nh-github/nav_lights/firmware/README.md

This directory contains firmware for the navigation lights
