nh-github/nav_lights/cad/cad_files/partlist.ods

parts | $/ea | footprint | digikey | mfr # | dscr | alt | note
Rc101 | 0.1 | R4-LARGE_PADS | JW50ZT0R00CT-ND | JW50ZT0R00 | RES 0.0 OHM 3A JUMP AXIAL | (SM/TH) 0 ohm resistor | Jumper for battery power
Rc102 | 0.1 | SM1206 | 1276-5742-1-ND | RC3216F103CS | RES SMD 10K OHM 1% 1/4W 1206 |  | LED temp sense, same as Rp107..
Rc103 | 0.67 | R4-LARGE_PADS | A105970CT-ND | 1622796-6 | RES 10.0K OHM 1/4W 0.1% AXIAL |  | LED temp sense
THc101 | 1.08 | SM1206 | 541-1150-1-ND | NTHS1206N02N1002JE | THERMISTOR NTC 10K OHM 5% 1206 | BC2558CT-ND (0805, 10k, 1%, B3570K) | LED temp, b=3500K
THc102 | 1.12 | R4-LARGE_PADS | 615-1054-ND | DC103G9G | THERMISTOR NTC 10K OHM 2% |  | LED temp, b=3575K
Uc101 | 0.26 | DIP-24__600_ELL | ED3051-5-ND | ED24DT | CONN IC SOCKET VERT 24POS TIN |  | use socket for arduino pro mini 3.3V 8MHz
BTp101, BTp102 | 1.36 |  | 2460K-ND | 2460 | HOLDER BATTERY 1CELL AA PC MNT |  | AA holder, Keystone Electronics
Cp101 | 0.28 | SM1206 | 445-14795-1-ND | C3216X7R1C475K085AB | CAP CER 4.7UF 16V 10% X7R 1206 | 445-1421-1-ND (0805, 4.7uF, 6.3V) | same as Cp201
Cp102 | 0.1 | SM1206 | 1276-1017-1-ND | CL31B104KBCNNNC | CAP CER 0.1UF 50V 10% X7R 1206 |  | CHECK
Cp103 | 0.16 | SM1206 | 1276-1783-1-ND | CL31B105KOFNNNE | CAP CER 1UF 16V 10% X7R 1206 |  | CHECK
Dp101 | 0.44 | DO-214AA | B340LB-FDICT-ND | B340LB-13-F | DIODE SCHOTTKY 40V 3A SMB
Dp102 | 0.44 | DO-214AA | B340LB-FDICT-ND | B340LB-13-F | DIODE SCHOTTKY 40V 3A SMB
Dp103 | 0.34 | SM1206 | 732-4994-1-ND | 150120YS75000 | WL-SMCW SMD CHIP LED WATERCLEAR |  | Yellow 1206 LED, 20mA
Lp101 | 1.88 |  | 445-10541-1-ND | SLF12565T-470M2R4-PF | FIXED IND 47UH 2.4A 57.8 MOHM
Pp101 |  | PIN_ARRAY_2X1 |  |  |  |  | CHECK
Qp101 | 0.78 | SOT23_6 | ZXM62P02E6CT-ND | ZXM62P02E6TA | MOSFET P-CH 20V 2.3A SOT23-6
Qp102 | 0.71 | SOT89 | FCX718CT-ND | FCX718TA | TRANS PNP 20V 2.5A SOT89
Rp101 | 0.1 | SM1206 | 1276-5690-1-ND | RC3216F331CS | RES SMD 330 OHM 1% 1/4W 1206
Rp102 | 0.1 | SM1206 | 1276-3514-1-ND | RC3216J000CS | RES SMD 0.0 OHM JUMPER 1/4W 1206
Rp103 | 0.1 | SM1206 | 1276-5685-1-ND | RC3216F271CS | RES SMD 270 OHM 1% 1/4W 1206
Rp104 | 0.1 | SM1206 | 1276-5675-1-ND | RC3216F151CS | RES SMD 150 OHM 1% 1/4W 1206
Rp105 | 0.1 | SM1206 | 1276-5742-1-ND | RC3216F103CS | RES SMD 10K OHM 1% 1/4W 1206
Rp106 | 0.1 | SM1206 | 1276-5671-1-ND | RC3216F101CS | RES SMD 100 OHM 1% 1/4W 1206
Rp107 | 0.1 | SM1206 | 1276-5742-1-ND | RC3216F103CS | RES SMD 10K OHM 1% 1/4W 1206 |  | same as Rp105
Rp108 | 0.1 | SM1206 | 1276-5742-1-ND | RC3216F103CS | RES SMD 10K OHM 1% 1/4W 1206 |  | same as Rp105
Rp109 | 0.1 | SM1206 | P10.0FCT-ND | ERJ-8ENF10R0V | RES SMD 10 OHM 1% 1/4W 1206
Rp110 | 0.1 | SM1206 | 1276-5762-1-ND | RC3216F333CS | RES SMD 33K OHM 1% 1/4W 1206
Rp111 | 0.1 | SM1206 | 1276-5784-1-ND | RC3216F124CS | RES SMD 120K OHM 1% 1/4W 1206
Rp112 | 0.21 | SM1206 | 1276-6178-1-ND | RUT3216FR300CS | RES SMD 0.3 OHM 1% 1/3W 1206
THp101, THp102 | 1.08 | SM1206 | 541-1150-1-ND | NTHS1206N02N1002JE | THERMISTOR NTC 10K OHM 5% 1206 | BC2558CT-ND (0805, 10k, 1%, B3570K) | batt temp sense, same as LED
Up101 | 5.35 | SOIC_16n | DS2712Z+-ND | DS2712Z+ | IC NIMH CHARGER 16SOIC
Cp201 | 0.28 | SM1206 | 445-14795-1-ND | C3216X7R1C475K085AB | CAP CER 4.7UF 16V 10% X7R 1206 |  | same as Cp101
Dp201 | 2.73 | XP-E2 | XPEBRD-L1-0000-00801CT-ND | XPEBRD-L1-0000-00801 | XLAMP XP-E2 COLOR LEDS | P0.91W-1BK-ND (th, $0.35/ea)
Dp202 | 0.68 | DO-216AA | MBRM120ET3GOSCT-ND | MBRM120ET3G | DIODE SCHOTTKY 20V 1A POWERMITE
Lp201 | 1.12 | SLF7045 | 445-2023-1-ND | SLF7045T-3R3M2R5-PF | FIXED IND 3.3UH 2.5A 20 MOHM SMD
Rp201 | 0.1 | SM1206 | P1.00MFCT-ND | ERJ-8ENF1004V | RES SMD 1M OHM 1% 1/4W 1206 | <many>
Rp202 | 0.27 | SM1206 | CRM1206-FX-R910ELFCT-ND | CRM1206-FX-R910ELF | RES SMD 0.91 OHM 1% 1/2W 1206
Up201 | 4.22 | SOIC_8n | LTC3490ES8#PBF-ND | LTC3490ES8#PBF | IC LED DRIVER PHOTO FLASH 8-SOIC
Dp301, Dp302 | 0.44 | DO-214AA | B340LB-FDICT-ND | B340LB-13-F | DIODE SCHOTTKY 40V 3A SMB
Kp301 |  | PIN_ARRAY_3X1
Rp301, Rp302 | 0.1 | SM1206 | 1276-5742-1-ND | RC3216F103CS | RES SMD 10K OHM 1% 1/4W 1206 |  | same as Rp105
Rp303 | 0.1 | SM1206 | 1276-3514-1-ND | RC3216J000CS | RES SMD 0.0 OHM JUMPER 1/4W 1206 |  | same as Rp102
SWp301 |  | PIN_ARRAY_2X1 |  |  |  |  | panel mount switch wired to board
Up301 | 1.07 | SOT23_5 | FPF2103CT-ND | FPF2103 | IC SWITCH LOAD FULL FUNC SOT23-5
