nh-github/nav_lights/cad/cad_files/nav_charge.sch

## KiCad design cad/cad_files/nav_charge.sch (2015-02-15)

Schematic: nav_charge.sch

Parts:
BTp101, BTp102: BATTERY; PIN_ARRAY_2X1; digikey 2461K-ND
Dp101: LED; SM1206; digikey 732-4994-1-ND
Rp101: 12; SM1206; digikey P12.0FCT-ND
Rp102: 270; SM1206; digikey 1276-5685-1-ND
Rp103: 10k; SM1206; digikey 1276-5742-1-ND
THp101: 103AT-2; PIN_ARRAY_2X1; digikey 615-1054-ND
Up101: LDO 1.2V; TO220_LDO; digikey MCP1827S-1202E/AB-ND

Notes on the sheet:
Stack: 0.3 -- 0.6 V regulator 1.2 V regulator feedback 1.2-1.5 V battery 1.2-1.5 V battery 4.8 V <- sum less than 5V input
Idea is connect to battery, not reg
Voltage across R -> 1.2 Volt 1 ohm -> approx. 1.2 Amp 6 ohm -> approx. 0.2 Amp (0.24 W dissipation) 12 ohm -> approx. 0.1 Amp (0.12 W ..) (1.2 V / Rsense) -> charge current
Mount holders w/ #2 screws (0.098" dia holes)
