nh-github/nav_lights/cad/cad_files/nav_control.sch

## KiCad design cad/cad_files/nav_control.sch (2015-02-15)

Schematic: nav_control.sch

Parts:
Dp301, Dp302: DIODE; DO-214AA; digikey B340LB-FDICT-ND
Kp301: CONN_3; PIN_ARRAY_3X1
Rc101: DNP; R4-LARGE_PADS; digikey JW50ZT0R00CT-ND
Rc102: 10k; SM1206; digikey 1276-5742-1-ND
Rc103: 10k; R3-LARGE_PADS; digikey A105970CT-ND
Rp301, Rp302: 10k; SM1206; digikey 1276-5742-1-ND
Rp303: DNP; SM1206
SWp301: SW_PUSH; PIN_ARRAY_2X1
THc101: 10k; SM1206; digikey 541-1150-1-ND
THc102: 10k; PIN_ARRAY_2X1; digikey 615-1054-ND
Uc101: ARDUINO_PRO_MINI; DIP-24__600_ELL
Up301: FPF2100; SOT23-5; digikey FPF2103CT-ND

Notes on the sheet:
Extra LEDs (w/ limiting resistors) on the unused pins?
A0 / A1 thermistor or similar for monitoring LED temperature (maybe battery too)
P6 to turn on LED (PWM: 3, 5, 6, 9, 10, 11) P7 to turn on power (when running with a soft switch)
GND top of vout ...board... Vbat
for power switching bypass (always on)
header for power supply (boost to 3.3 or 5 V) check rotation... NCP1402 based PRT-10967
jumper towards DS2712::LED1 for charger activity monitoring
P2 (INT0) for power button sensing P3 (INT1) for charger status sensing P5 for led status sensing (polled)
