nh-github/nav_lights/cad/cad_files/nav_light.sch

## KiCad design cad/cad_files/nav_light.sch (2015-02-15)

Schematic: nav_light.sch

Parts:
MECH5, MECH6, MECH7: MECH; fiducial
MECH8: MECH; logo-OSHW_3mm
MECH101, MECH102, MECH103, MECH104: MECH; mech_hole__2
Pp101: CONN_2; PIN_ARRAY_2X1
