nh-github/nav_lights/cad/cad_files/nav_output.sch

## KiCad design cad/cad_files/nav_output.sch (2015-02-15)

Schematic: nav_output.sch

Parts:
Cp201: 4.7uF; SM1206; digikey 445-1421-1-ND
Dp201: LED; XP-E2; digikey XPEBRD-L1-0000-00801CT-ND
Dp202: DIODE; DO-216AA; digikey MBRM120ET3GOSCT-ND
Dp203: LED; PIN_ARRAY_2X1; digikey XPEBRD-L1-0000-00801CT-ND
Lp201: 3.3uH; SLF7045; digikey 445-2023-1-ND
Rp201: 1M; SM1206; digikey P1.00MCCT-ND
Rp202: 0.91; SM1206; digikey CRM0805-FX-R910ELF
Up201: LTC3490ES8; SOIC_8n; digikey LTC3490ES8#PBF-ND

Notes on the sheet:
<= use only one of these alternates
Drop 0.3V (@0.35A) over resistor => 0.85 Ohm, 0.105W
LED output from 3490 must be >= 2.5V XP-E2 green and red have Vf of 2.2 & 3.2 Add LED to boost voltage
NOTE: * Choose one LED footprint to populate * $4 ASMT-AR00-ARS00 (red); 516-2565-ND / no green * $3.75 LXM2-PD01-0050 (red); LXML-PM01-0090 (green) * $2.75 XPEBRD-L1-0000-00801 (red); XPEBGR-L1-0000-00E01 (green) * $1.25 Cree ML-E (MLERED-A1-0000-000V01, MLEGRN-A1-0000-000X01) [dim]
