nh-github/nav_lights/doc/licensing/CHANGES.TXT

CERN OHL stub

Use this to note modifications made by Licensee (see license section 3.4.b)
