nh-github/nav_lights/(commit log)

2013-12-27 tracking general arduino sketches
    LED light strips and patterns
2013-12-27 LED Strip control
    adding a twinkling light concept
2014-07-25 initial commit of [schematic] cad files
    LED driver (LTC3490): schematic drawn, need footprints
    charger (DS2712): schematic in progress
    TODO:
    * soft power,
    * load disable/disconnect,
    * control(s),
    * battery/led details
    [nav_battery.sch, nav_charge.sch, nav_control.sch, nav_light.sch, nav_output.sch, nav_special.sch]
2014-07-25 DS2712 circuit, somewhat
    datasheet fig.3 - lacks current regulation
    [nav_charge.sch, nav_control.sch, nav_light.sch, nav_output.sch, nav_special.sch]
2014-07-31 NiMH Battery Charging update
    * DS2712 charger, 2S configuration,
    * circuit modeled on eval board schematic
    [nav_charge.sch]
2014-08-01 removing old charging circuit
    updating/fixing up new circuit (from app-note)
    [nav_charge.sch]
2014-08-03 charger schematic work
    * modify DS2712 schematic element
    - pin locations
    * sheet I/O ``pins'' updating
    * adding notes/comments
    [nav_charge.sch]
2014-08-03 adding wires for nav_control soft power
    [nav_control.sch]
2014-08-03 updating LED driver / output schematic page
    * component rearrangement
    * adding IO ``pins''
    [nav_output.sch]
2014-08-03 changelog noise
    kicad last opened metadata in headers
    [nav_light.sch, nav_special.sch]
2014-12-02 Updating control plan
    Add notes for signals/pins
    Add power supply footprint (boost vbat to 3.3 or 5 V for microcontroller)
    Add bypass for power supply switching
    [nav_charge.sch, nav_control.sch, nav_light.sch, nav_output.sch, nav_special.sch]
2014-12-02 Import Hierarchical Pins for interconnection
    [nav_charge.sch, nav_light.sch, nav_output.sch]
2014-12-02 Arrange power and control connections
    [nav_control.sch, nav_light.sch]
2014-12-03 Add Arduino Pro Mini for control
    [nav_control.sch, nav_light.sch]
2014-12-03 Update arduino pro schematic
    [nav_control.sch]
2014-12-03 Update metadata
    [nav_charge.sch, nav_light.sch, nav_output.sch]
2014-12-03 Bring out battery charge status
    LED1 flashes an LED to indicate charging/not-charging/error conditions
    Connect it to a hierarchical pin for monitoring by microcontroller
    [nav_charge.sch]
2014-12-03 Bring charge status signal to control logic
    [nav_charge.sch, nav_control.sch, nav_light.sch]
2014-12-03 Update control schematic
    re-arrange Vppath (power path voltage rail)
    re-arrange microcontroller pin--signal ordering
    [nav_charge.sch, nav_control.sch, nav_light.sch, nav_output.sch]
2014-12-04 Adding refdes details for nav_charge
    [nav_charge.sch, nav_control.sch, nav_light.sch, nav_output.sch]
2014-12-04 Adding refdes details for nav_control
    [nav_charge.sch, nav_control.sch, nav_light.sch, nav_output.sch]
2014-12-04 Changing transistor to load switch for soft power
    FPF2103 or a related model
    [nav_charge.sch, nav_control.sch, nav_light.sch, nav_output.sch]
2014-12-04 Change power input to 2-pin part
    [nav_charge.sch, nav_control.sch, nav_light.sch, nav_output.sch]
2014-12-04 Add refdes for inductor
    [nav_charge.sch, nav_control.sch, nav_light.sch, nav_output.sch]
2014-12-04 ERC clearing
    [nav_charge.sch, nav_control.sch, nav_light.sch, nav_output.sch]
2014-12-07 Prep for layout
    add footprints, refine design
    [nav_charge.sch, nav_control.sch, nav_light.sch, nav_output.sch]
2014-12-09 Prep for layout (continued)
    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
    [nav_charge.sch, nav_control.sch, nav_light.sch, nav_output.sch]
2014-12-10 Make footprints visible in schematic
    [nav_charge.sch, nav_control.sch, nav_light.sch, nav_output.sch]
2014-12-11 Prep for layout (continued)
    Add footprints, refine design
    add additional ``LED footprint'' (pin header)
    [nav_charge.sch, nav_control.sch, nav_light.sch, nav_output.sch]
2014-12-17 Updates during layout
    [nav_charge.sch, nav_control.sch, nav_light.sch, nav_output.sch]
2014-12-24 Moving wires
    [nav_charge.sch]
2014-12-24 Minor changes
    Add parts to Library
    Change footprint for mounting holes (#2)
    [nav_control.sch, nav_light.sch, nav_output.sch]
2014-12-24 Layout sketch
    note: much larger than desired
    [nav_light.brd]
2014-12-24 Switch to slow charger (0.1 -- 0.2 A)
    Use linear power supply to limit current
    [nav_charge.sch, nav_control.sch, nav_light.sch, nav_output.sch]
2014-12-24 Fine tuning
    also adding notes on expected operation
    [nav_charge.sch, nav_control.sch, nav_light.sch, nav_output.sch]
2014-12-24 Adding LDO part
    Existing parts in libs (schematic and layout) don't line up!!?!
    [nav_charge.sch, nav_control.sch, nav_light.brd, nav_light.sch, nav_output.sch]
2014-12-24 Drop one alternate LED footprint
    [nav_charge.sch, nav_control.sch, nav_light.sch, nav_output.sch]
2014-12-24 Board layout
    Mostly connected, still needs optimization
    [nav_charge.sch, nav_control.sch, nav_light.brd, nav_light.sch, nav_output.sch]
2014-12-24 BoM updating (adding to schematic)
    [nav_charge.sch, nav_control.sch, nav_light.brd, nav_light.sch, nav_output.sch]
2014-12-24 Bom updating (and schematic) for LED power
    [nav_charge.sch, nav_control.sch, nav_light.sch, nav_output.sch]
2014-12-25 Rearranging a few tracks (on board)
    [nav_charge.sch, nav_control.sch, nav_light.brd, nav_light.sch, nav_output.sch]
2014-12-25 BoM as partlist
    [partlist.ods]
2014-12-26 Updating BoM for simplified board
    [partlist.ods, partlist__dk_order.csv]
2014-12-26 Updating layout
    re-arranging / updating / cleaning
    [nav_light.brd]
2014-12-26 Layout: silkscreen improvements
    [nav_light.brd]
2014-12-27 Change TH thermistor footprint
    switch from ``resistor'' to ``pin header'' style footprints
    [nav_charge.sch, nav_control.sch, nav_light.sch, nav_output.sch]
2014-12-27 Poking at layout (esp LED)
    [nav_light.brd]
2014-12-27 Drop obsolete files
    [nav_battery.sch, nav_special.sch]
2014-12-27 Re-arranging LED section
    Working over thermal spreading
    Resizing refdes markings
    Moving thermistors
    [nav_charge.sch, nav_control.sch, nav_light.brd, nav_light.sch, nav_output.sch]
2014-12-28 Poking around...
    [nav_light.brd]
2014-12-28 Added small vias under LED
    [nav_light.brd]
2014-12-28 Minor changes
    [nav_light.brd]
2014-12-28 Add copyright marking
    [nav_light.brd]
2014-12-28 Layout improvements
    [nav_light.brd]
2014-12-28 Updating silkscreen
    * P/N for LED Driver (LTC3490)
    * note battery and power connections
    [nav_light.brd]
2014-12-28 Update silkscreen
    * power switch label
    [nav_light.brd]
2014-12-29 Adding non-electrical footprints
    * add lib for logos
    * add fiducial marks to lib
2014-12-29 Add fiducial marks (as mech entities in schmatic)
    [nav_charge.sch, nav_control.sch, nav_light.sch, nav_output.sch]
2014-12-29 Add fiducial marks
    [nav_light.brd]
2014-12-29 Minor re-positioning and editing
    [nav_charge.sch, nav_control.sch, nav_light.brd, nav_light.sch, nav_output.sch]
2014-12-29 Fix footprints for TH thermocouple & resistor
    THc102 and Rc103 (near lower edge of board, HPLED, and ext led connector)
    [nav_charge.sch, nav_control.sch, nav_light.brd, nav_light.sch, nav_output.sch]
2014-12-29 Graphics update
    [nav_light.brd]
2014-12-29 Remove unconnected track segment
    [nav_light.brd]
2014-12-29 LED to ``regulated'' side of LDO
    Status LED was connected to power connector (in parallel w/ LDO)
    Moving it to LDO output may allow higher input voltages for charging.
    [nav_charge.sch, nav_control.sch, nav_light.sch, nav_output.sch]
2014-12-29 Layout Update (status LED wiring)
    [nav_light.brd]
2014-12-31 Expand ground plane area
    re-arrange text on board
    [nav_light.brd]
2014-12-31 Silkscreen cleanup
    also moved Dp101 and Rp102 away from board edge
    [nav_light.brd]
2014-12-31 Filling copper zones
    [nav_light.brd]
2014-12-31 Updates to silkscreen labels
    mostly fixing positions and some sizes
    [nav_light.brd]
2015-01-01 Changing status LED connection
    Old: connected to fb pin on LDO (turn on while charging)
    New: connected to pin on uC (sw control)
    [nav_charge.sch, nav_control.sch, nav_light.sch, nav_output.sch]
2015-01-01 Updating led connection and nearby silkscreen
    [nav_light.brd]
2015-01-01 Fill copper zones
    [nav_light.brd]
2015-01-01 Re-order pin connection(s)
    also another change or two
    [nav_charge.sch, nav_control.sch, nav_light.sch, nav_output.sch]
2015-01-01 Misc changes to layout
    [nav_light.brd]
2015-01-01 Move pin changes in other direction...
    [nav_charge.sch, nav_control.sch, nav_light.sch, nav_output.sch]
2015-01-01 Modified grounding near LED
    cutout in main groundplane, added small area (on top side) for just LED
    5mil space between the two and all corners are tied to backside groundplane
    [nav_light.brd]
2015-01-01 Board text: change date: 2014 -> 2015
    [nav_light.brd]
2015-01-02 Power LED directly from battery
    [nav_charge.sch, nav_control.sch, nav_light.sch, nav_output.sch]
2015-01-02 Connect HPLED power to batteries (schematic)
    HPLED supply was connected to battery through lower current switch.
    Now relying on power supply to not draw current when off.
    [nav_charge.sch, nav_control.sch, nav_light.sch, nav_output.sch]
2015-01-02 Update layout with schematic changes
    [nav_light.brd]
2015-01-03 Minor modifications after dry-fit w/ printout
    Add exposed copper adjacent to SMD pads
    NOTE: LDO heatsink may interfere w/ mounting hole
    [nav_light.brd]
2015-01-03 Add tracks under pad solder mask extensions
    [nav_light.brd]
2015-01-27 Thread for indicators updated
2015-01-29 Add stdC++ lib for support library use
    also drop some print statements
2015-01-29 Update for callbacks
    Comment function pointer example code
    Modify thread interfaces for callback style update propagation
2015-01-29 Update using callbacks
    Change button logic to check edge timing (and holding since edge timing)
    Call provided functions for ``interesting things'' (button events)
2015-02-17 rename arduino file for IDE compat
    file path/name needs to be examples/name/name.ino to show up
2015-02-25 Add some prints in setup()
2015-02-25 split out button interface to separate file
2015-03-06 Fix variable declaration to avoid casting
    [lightingctrl.h]
2015-03-06 Debug prints
